mgiesen/Luminous-Hallway/(commit log)

2024-01-28 Added update Button to frontend
2024-01-28 Prevent accidental device turn-off by disallowing zero brightness
2025-11-23 Umstrukturierung und Optimierung firmware
2025-11-23 Refactor und Implementierung neuer Animationen
